RaphaelMuthenya/vertical-lift-bridge/bom/VLB_Group7_BOM.xlsx

# | Item | Part / Spec | Supplier | Unit (KES) | Qty | Total (KES) | Justification / Notes
MECHANICAL
1 | JGA25-370 12V DC gearmotor 100 RPM Hall encoder | JGA25-370 100RPM | Nerokas | 1450 | 1 | 1450 | Main lift drive — 4.0 kg·cm enough for 175 mm deck + 2× counterweight
2 | Aluminium spool/drum Ø30 mm × 25 mm | Custom (Sagana machine shop) | Sagana | 600 | 1 | 600 | Cable wrap drum — keyed to motor 6 mm shaft
3 | Braided steel cable Ø1.0 mm (3 m) | 1mm 7×7 braided | Luthuli | 350 | 1 | 350 | 2× 1 m cables for counterweights + 0.5 m spares
4 | Pulley wheel groove Ø50 mm (3D printed) | PLA — see CAD | In-house print | 0 | 4 | 0 | Top of each tower — 2 left + 2 right
5 | 608 ZZ skate bearing (8×22×7) | 608ZZ | Luthuli | 50 | 8 | 400 | Pulley axles + drum bearings
6 | Lead fishing weight 60 g (counterweight fill) | Strip — bulk | Luthuli | 80 | 4 | 320 | 2× 120 g counterweights = 4× 60 g pieces
7 | MGN12 linear rail 200 mm + carriage | MGN12-200 set | Nerokas | 1250 | 2 | 2500 | Bridge deck guides — 1 per tower
8 | SG90 micro servo (barrier arms) | SG90 9g | Nerokas | 250 | 2 | 500 | Two road barrier servos
9 | HC-SR04 ultrasonic module | HC-SR04 | Nerokas | 180 | 4 | 720 | Dual beam direction inference
10 | ESP32-CAM AI-Thinker (vehicle vision) | ESP32-CAM OV2640 | Nerokas | 1500 | 1 | 1500 | Frame-difference vehicle detection on UART2
11 | Limit switch microswitch SPDT | KW11-3Z lever | Pixel | 80 | 4 | 320 | Top + bottom limit per tower (2 + 2 redundant)
12 | 3D-print PLA filament 1 kg (white + grey) | PLA generic | ASK | 1400 | 1 | 1400 | All printed parts + spares
13 | Brass M3 thread insert (knurled) | M3 heat-set | Nerokas | 12 | 50 | 600 | PCB stand-offs, panels, motor mount
14 | M3×8 socket cap screws (pack) | M3×8 | Luthuli | 10 | 30 | 300 | General assembly
15 | M3×16 socket cap screws (pack) | M3×16 | Luthuli | 12 | 20 | 240 | Through-mount for towers
16 | M8×80 mm bolt + nut (pulley axle) | M8×80 | Luthuli | 60 | 2 | 120 | Top-pulley axles
17 | Aluminium L-bracket 25×25×3 mm × 1 m | L-stock | Luthuli | 350 | 1 | 350 | Tower base reinforcement
18 | MDF / plywood base 1200×600×12 mm | MDF 12 mm | Sagana | 1200 | 1 | 1200 | Project footprint base — printed panels overlay
 | Subtotal — MECHANICAL |  |  |  |  | 12870
ELECTRONICS — PCB COMPONENTS, TFT, CAM
1 | ESP32-WROOM-32E module (38-pin DevKit) | ESP32-WROOM-32E | Nerokas | 850 | 1 | 850 | Main controller
2 | L293D H-bridge driver module | Motor Driver | Nerokas | 1100 | 1 | 1100 | Motor driver — overspec'd for safety margin
3 | AMS1117-3.3 LDO regulator | AMS1117-3.3 SOT-223 | Pixel | 35 | 3 | 105 | 3.3 V rail (1 used, 2 spare)
4 | LM2596 step-down buck module 12→5 V | LM2596 adj | Nerokas | 220 | 1 | 220 | 5 V rail for servos + ESP32-CAM
5 | 12 V / 3 A DC barrel adapter | 5.5×2.1 mm DC | Nerokas | 600 | 1 | 600 | Primary supply
6 | DC barrel jack 5.5×2.1 mm panel mount | DCJ0202 | Pixel | 45 | 1 | 45 | Power input on PCB
7 | DC-DC Schottky 5 A SS54 | SS54 | Pixel | 25 | 2 | 50 | Reverse-polarity protection
8 | Polyfuse PTC 2 A hold (12 V rail) | RXEF200 | Pixel | 40 | 1 | 40 | Resettable fuse on 12 V input
9 | TVS diode SMBJ15CA (transient on 12 V) | SMBJ15CA | Pixel | 35 | 1 | 35 | Surge protection
10 | AO3400A N-MOSFET (backlight + buzzer) | AO3400A SOT-23 | Pixel | 25 | 4 | 100 | Logic-level switches
11 | 2N7000 N-FET (relay coil drive) | 2N7000 | Pixel | 20 | 2 | 40 | Low-side switch for relay
12 | SRD-05VDC-SL-C 5 V relay (E-stop chain) | SRD-05VDC-SL-C | Nerokas | 90 | 1 | 90 | Motor power kill
13 | 74HC595 8-bit shift register (DIP-16) | 74HC595 | Pixel | 25 | 2 | 50 | Traffic-light LED chain (1 + 1 spare)
14 | XPT2046 + ILI9341 2.8" 240×320 TFT touch | TJCTM24028-SPI | Nerokas | 1200 | 1 | 1200 | Operator dashboard — TN panel
15 | Passive piezo buzzer 12 mm | Generic 12 mm | Pixel | 50 | 1 | 50 | Alarm + chirp
16 | Mushroom E-stop NC switch (panel) | 16 mm NC mushroom | Nerokas | 320 | 1 | 320 | Hard safety stop
17 | Tactile push-button 6×6 mm (panel) | 6×6×5 mm | Pixel | 8 | 6 | 48 | Front-panel resistor-ladder buttons
18 | Resistor ladder kit 1 kΩ × 5 (1 % 0805) | 1 kΩ 1 % 0805 | Pixel | 5 | 10 | 50 | Button ladder + voltage dividers
19 | 0805 resistor assortment kit | Yageo 0805 | Pixel | 250 | 1 | 250 | All passive resistors
20 | 0805 / SMD-A capacitor assortment | 100 nF / 10 µF / 100 µF | Pixel | 280 | 1 | 280 | Decoupling + bulk caps
21 | LED 0805 R/Y/G traffic chain | 0805 SMD LED | Pixel | 6 | 12 | 72 | 6× road + 6× marine + spares
22 | JST-XH 4-pin connector + crimp pins | JST-XH 2.54 | Pixel | 30 | 4 | 120 | TFT, CAM, sensor harnesses
23 | USB-UART CH340G module (programming header) | CH340G | Nerokas | 280 | 1 | 280 | Backup programmer — DevKit has built-in
 | Subtotal — ELECTRONICS — PCB COMPONENTS, TFT, CAM |  |  |  |  | 5995
PCB FABRICATION & ASSEMBLY
1 | PCB fab 100×80 mm 2-layer FR4 HASL-LF (qty 5) | JLCPCB / PCBWay | Online (DHL) | 1900 | 1 | 1900 | Includes shipping to KE — ~1.6 mm, matte black mask
2 | Stencil 100×80 mm framed | JLCPCB stencil | Online | 700 | 1 | 700 | Optional but speeds reflow
3 | Solder paste Sn63/Pb37 35 g (no-clean) | Mechanic 35 g | Pixel | 600 | 1 | 600 | For SMD reflow
4 | 0.6 mm leaded solder wire 100 g | 60/40 | Pixel | 350 | 1 | 350 | Through-hole + rework
5 | Flux pen / paste no-clean | AMTECH 559 | Pixel | 280 | 1 | 280 | Rework aid
6 | Isopropyl alcohol 250 mL 99 % | IPA | ASK | 280 | 1 | 280 | Board cleaning
 | Subtotal — PCB FABRICATION & ASSEMBLY |  |  |  |  | 4110
CONSUMABLES & MISC
1 | Heat-shrink tubing assortment | 1.5–6 mm pack | Luthuli | 250 | 1 | 250 | Wire termination
2 | Hookup wire 22 AWG silicone (3 colors) | 22AWG silicone | Pixel | 350 | 1 | 350 | Power harness — 5 m total
3 | Hookup wire 26 AWG ribbon | 26AWG ribbon | Pixel | 250 | 1 | 250 | Signal harness
4 | Cable ties 100 mm + 200 mm | Mixed pack | Luthuli | 120 | 1 | 120 | Routing
5 | Hot-melt glue stick 7 mm × 30 | EVA glue stick | Luthuli | 180 | 1 | 180 | Print joining + strain relief
6 | Project enclosure ABS 150×100×60 mm | Generic ABS | Pixel | 450 | 1 | 450 | Backup if 3D-printed enclosure fails
7 | Acrylic 3 mm × A4 (deck overlay decals) | 3 mm clear | Luthuli | 250 | 1 | 250 | Deck markings overlay
 | Subtotal — CONSUMABLES & MISC |  |  |  |  | 1850
 | GRAND TOTAL (KES) |  |  |  |  | 24825
 | Notes:
 | All prices in Kenyan Shillings (KES), VAT-inclusive where applicable.
 | Supplier shorthand: Nerokas (Nerokas Cyber Systems, Nairobi); Pixel (Pixel Electric, Luthuli Avenue);
 | ASK (ASK Electronics, Tom Mboya); K-Technics (online KE); Luthuli/Sagana (street suppliers).
 | PCB fab quoted JLCPCB 5pcs 100×80 mm 2-layer + DHL ~7 days to Nairobi (≈ KES 1,900 all-in).
 | Counterweights: 4× 60 g lead = 240 g total -> 120 g per side, balances 240 g deck assy with 1.0× SF.
 | Lead unit: BLUE = manually entered input; BLACK = formula. Adjust E:F cells to scale procurement.
