RaphaelMuthenya/vertical-lift-bridge/firmware/src/traffic/traffic_lights.cpp

// ============================================================================
// traffic/traffic_lights.cpp — Drives 74HC595 chain.
// Bit map (Q0..Q5 of first 595):
//   bit0 ROAD_R, bit1 ROAD_Y, bit2 ROAD_G,
//   bit3 MARINE_R, bit4 MARINE_Y, bit5 MARINE_G
// Owner: M4 Abigael
//
// Pin-sharing note (v2.2): the four 74HC595 control lines share physical
// GPIOs with HC-SR04 driver lines (see pin_config.h §LIMIT SWITCHES and
// §TRAFFIC LIGHTS). The compromise:
//
//   • DATA  (GPIO 23, also US3_ECHO) — toggled OUTPUT only during shift,
//     restored to INPUT_PULLUP between shifts so US3 can read its echo.
//   • CLOCK (GPIO 18, also US1_ECHO) — same toggle scheme; US1 echo OK.
//   • LATCH (GPIO 19, also US2_TRIG) — both drivers want OUTPUT; we
//     leave it permanently OUTPUT and just write the rising edge here.
//   • OE    (GPIO 21, also US2_ECHO) — permanent OUTPUT LOW (must hold
//     its level or the LEDs would dim/extinguish). This means GPIO 21
//     cannot be shared, so US2_ECHO is permanently disabled in v2.2
//     (cf. known_limitations.md L8).
// ============================================================================
#include "traffic_lights.h"
#include "../pin_config.h"
#include "../system_types.h"
#include <Arduino.h>
#include <freertos/FreeRTOS.h>
#include <freertos/semphr.h>

static TrafficLightState_t s_road   = TL_OFF;
static TrafficLightState_t s_marine = TL_OFF;
static uint8_t              s_blink_phase = 0;

static void shift_out(uint8_t byte) {
    // Briefly steal the DATA and CLOCK lines from the HC-SR04 driver.
    // INPUT_PULLUP is the "release" mode — US1 (CLOCK pad) and US3
    // (DATA pad) can read their ECHO lines between shifts.
    //
    // LATCH (GPIO 19) is shared with US2_TRIG, which is already an
    // OUTPUT — both drivers want the same direction, so we leave LATCH
    // permanently OUTPUT and just write the rising edge here.
    pinMode(PIN_595_DATA,  OUTPUT);
    pinMode(PIN_595_CLOCK, OUTPUT);

    digitalWrite(PIN_595_LATCH, LOW);
    shiftOut(PIN_595_DATA, PIN_595_CLOCK, MSBFIRST, byte);
    digitalWrite(PIN_595_LATCH, HIGH);

    // Hand DATA and CLOCK back. The 74HC595 latches on the LATCH rising
    // edge above, so subsequent INPUT_PULLUP on these control lines does
    // NOT change the LED state.
    pinMode(PIN_595_DATA,  INPUT_PULLUP);
    pinMode(PIN_595_CLOCK, INPUT_PULLUP);
}

static uint8_t state_to_bits(TrafficLightState_t s, uint8_t base_shift, bool blink_on) {
    uint8_t r = 0, y = 0, g = 0;
    switch (s) {
    case TL_GREEN:        g = 1; break;
    case TL_AMBER:        y = 1; break;
    case TL_RED:          r = 1; break;
    case TL_AMBER_BLINK:  y = blink_on ? 1 : 0; break;
    case TL_RED_BLINK:    r = blink_on ? 1 : 0; break;
    default: break;
    }
    return (r << base_shift) | (y << (base_shift + 1)) | (g << (base_shift + 2));
}

void traffic_lights_init(void) {
    // OE stays a permanent OUTPUT (driven LOW = chain enabled).
    // LATCH (shared with US2_TRIG) is already configured OUTPUT by
    // sensors_ultrasonic_init — both drivers want OUTPUT, so we just
    // assert the idle level here.
    // DATA and CLOCK rest as INPUT_PULLUP so the HC-SR04 driver can use
    // the same physical GPIOs for ECHO reads between shifts (cf. file
    // header).
    pinMode(PIN_595_OE,   OUTPUT);
    digitalWrite(PIN_595_OE, LOW);
    pinMode(PIN_595_LATCH, OUTPUT);
    digitalWrite(PIN_595_LATCH, HIGH);    // idle high — released
    pinMode(PIN_595_DATA,  INPUT_PULLUP);
    pinMode(PIN_595_CLOCK, INPUT_PULLUP);
    shift_out(0);                          // clear all LEDs at boot
    Serial.println("[lights] init OK");
}

void traffic_lights_set_road(TrafficLightState_t s)   { s_road = s; }
void traffic_lights_set_marine(TrafficLightState_t s) { s_marine = s; }

void traffic_lights_tick(void) {
    s_blink_phase ^= 1;
    bool on = (s_blink_phase != 0);
    uint8_t bits = state_to_bits(s_road, 0, on) | state_to_bits(s_marine, 3, on);
    shift_out(bits);

    if (xSemaphoreTake(g_status_mutex, pdMS_TO_TICKS(5)) == pdTRUE) {
        g_status.lights_road   = bits & 0x07;
        g_status.lights_marine = (bits >> 3) & 0x07;
        xSemaphoreGive(g_status_mutex);
    }
}
