RaphaelMuthenya/vertical-lift-bridge/(commit log)

2026-05-09 v2.2: align firmware + docs to BOM, fix integration gaps, restore operator panel
    Firmware bug fixes
    - main.cpp: schedule traffic_lights_tick / buzzer_tick / input_tick from
    task_safety (LEDs and buzzer patterns previously never ran).
    - motor_driver.cpp: implement position-based top/bottom limit
    discrimination promised by docs/known_limitations.md L2; remove dead
    Hall-encoder ISR; correct 13-bit PWM comment.
    - interlocks.cpp: fix dead-code BARRIER_TIMEOUT (reach < timeout); emit
    EVT_BARRIER_CLOSED / EVT_BARRIER_OPEN on rising edge so FSM no longer
    waits on the periodic 100 ms tick.
    - fsm_engine.cpp: wire EVT_HOLD_TIMEOUT inside RAISED_HOLD using state
    age, and EVT_OPERATOR_HOLD in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
    [00_common.scad, 02_tower_right.scad]
2026-05-09 v2.2 follow-up: close residual implementation gaps found by atomic re-sweep
    Firmware fixes
    - counterweight.cpp: arm s_was_balanced=false in counterweight_set_target
    so EVT_CW_READY fires even when the requested target equals the
    current water level. Previously the FSM hung in STATE_ROAD_CLEARING
    on every fresh boot because the default 120 ml target matched the
    init level and no rising edge produced.
    - hmi/display.cpp: HMI_CMD_CLEAR_FAULT now calls fault_register_clear_all
    before posting EVT_FAULT_CLEARED. Without the clear, the next safety
    tick would re-emit EVT_FAULT_RAISED and bounce the FSM straight back
    to STATE_FAULT.
    - hmi/input.cpp: BAND_TOL reduced 120 -> 80 to match th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
    [display.cpp, input.cpp, interlocks.cpp, main.cpp, motor_driver.cpp, pin_config.h, system_types.h]
2026-05-09 v2.2 polish: boot-time deck zero, CAM phantom-detect fix, stale comment + asset notes
    Firmware
    - motor_driver.cpp: motor_driver_init() now seeds s_adc_zero from a
    4-sample average at boot, so the deck-position estimate is sane on
    the very first FSM cycle (was effectively random until the first
    bottom-limit hit).
    - firmware_cam/src/main.cpp: detection-hold branch now checks
    s_last_detect_ms != 0, suppressing a phantom v=1 line during the
    first ~400 ms after boot when the variable is still its zero-init
    value. Without this, the main board could see a fake
    EVT_VEHICLE_DETECTED at startup.
    - traffic_lights.cpp: header comment was still describing the
    DATA/CLOCK/LATCH-toggle schem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
    [main.cpp, motor_driver.cpp, traffic_lights.cpp]
2026-05-09 v2.2 polish #2: FSM stale-state reset, brightness shared state
    - fsm/fsm_engine.cpp: hoisted s_cw_ok from the STATE_ROAD_CLEARING case
    block to a file-static, and added a reset in enter_state() whenever
    STATE_ROAD_CLEARING is re-entered. Without the reset, an EVT_CW_READY
    received during one cycle that was then aborted by ESTOP/FAULT would
    carry over via the function-static and short-circuit the next cycle's
    counterweight wait. The fresh entry now always starts with
    s_cw_ok = false and waits for the new EVT_CW_READY.
    - hmi/display.cpp: HMI_CMD_BRIGHTNESS_UP and HMI_CMD_BRIGHTNESS_DOWN
    now share a single static counter. Previously each branch had its
    own static (initi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
    [display.cpp]
2026-05-10 v2.2 polish #3: PCB enclosure label + unused tunable annotations
    - cad/scad/11_pcb_enclosure.scad: lid silkscreen substitute label was
    "VLB-G5" — corrected to "VLB-G7" to match the actual group number.
    (Drift from the pre-renumbering era; flagged in proposal D9.)
    - firmware/src/system_types.h: three tunables had no users in the v2.2
    source — DECK_HEIGHT_MIN_MM, DECK_HEIGHT_TOLERANCE_MM, and
    WATCHDOG_KICK_PERIOD_MS. Annotated each as "Reserved" with the
    rationale for keeping the symbol around (v3 will need them, or a
    future centralised kick scheduler may use it).
    [11_pcb_enclosure.scad]
2026-05-10 v2.2 polish #4: M1 boot-log expectation refreshed
    The expected boot log in member_guides/M1 was missing the v2.2-era
    [input] init line and showed the pre-v2.2 short form of the [motor]
    init line. Aligned the documented log with what motor_driver.cpp and
    input.cpp actually emit so the troubleshooting check ("does my serial
    monitor show this exact sequence?") works.
2026-05-10 v2.2 polish #5: known_limitations L5 table corrected to actual pin map
    The L5 GPIO-conflict table in docs/known_limitations.md listed PIN_BUZZER
    on GPIO 0, but pin_config.h's final #define puts PIN_BUZZER on GPIO 1
    (after the #undef chain). Rebuilt the table to enumerate every actual
    pin-sharing case in the v2.2 firmware:
    - GPIO 5 / 22: SERVO + US TRIG
    - GPIO 18 / 23: 595 CLOCK/DATA + US ECHO (toggled INPUT_PULLUP between shifts)
    - GPIO 19: 595 LATCH + US2 TRIG (both want OUTPUT)
    - GPIO 21: 595 OE + US2 ECHO (US2 ECHO permanently dead — see L8)
    - GPIO 0: ESTOP_IRQ + BOOT (no buzzer here)
    - GPIO 1: BUZZER + US4 TRIG + UART0 TX (the actual buzzer location)
    Each entry now explains how the co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
2026-05-10 v2.2 polish #7: propagate the L8 ultrasonic caveat into M3 + README
    - member_guides/M3_Cindy_Vision_Sensors.md: added a banner at the top
    of Step 5 (HC-SR04 install) so M3 doesn't waste hours debugging
    US1/2/3 as if they were wiring faults — they're documented v2.2
    pin-sharing limitations. The bench testing instructions still apply
    (the wiring is v3-ready), but only US4 will return real distances
    in v2.2 production.
    - member_guides/M3_Cindy_Wokwi_Simulation_Guide.md: noted that Wokwi
    has none of the v2.2 pin-sharing constraints, so it remains the
    right place to validate the direction-inference algorithm itself
    before the v3 board arrives.
    - README.md: task_sensors row + ult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
2026-05-10 v2.2 polish #8: align README + M4 with L1 (no rail sense) and L7 (no barrier-timeout)
    - README.md task table: task_telemetry no longer claims to monitor
    voltage rails — that path was removed in v2.1 / kept removed in
    v2.2 (see L1).
    - member_guides/M4_Abigael_Traffic_HMI.md: FaultRow table omits
    FAULT_BARRIER_TIMEOUT (reserved-but-unset per L7), matching the
    earlier FAULT_OVERCURRENT omission. Both flags physically can never
    fire in v2.2, so listing them on the FAULTS screen would just take
    up space that never lights up.
2026-05-10 fix(fsm): correct vision vs ultrasonic responsibilities
    - Vision camera is solely responsible for detecting road traffic stuck on the bridge deck.
    - Ultrasonic sensors are solely responsible for detecting approaching marine vessels.
    - fsm_guard_can_clear_road now only triggers on ultrasonic (or manual operator).
    - fsm_guard_road_clear now explicitly requires !vision.vehicle_present before the motor can engage.
    [VLB_Group7_BOM.xlsx]
